warmekaassaus/guitarpedal/(commit log)

2026-10-01 add proven interrupt-based encoder read test
2026-10-01 MVP firmware tested, leds not lit still. potentially hw issue.
    [firmware.ino]
2026-10-05 faster led update and instant feedback from pedal press
2026-10-05 add blue confirmation flash when resetting timer
    [firmware.ino]
2026-10-05 add lock/unlock logic to prevent accidental edits
    [firmware.ino]
2026-10-05 prevent pedal presses while unlocked
    [firmware.ino]
2026-10-05 prevent knob inputs while running or paused - only allow while at base time
    [firmware.ino]
2026-10-05 cleaned up oled viz and blue flashes on all resets, add reset on pedal during overtime
    [firmware.ino]
2026-10-05 pedal hold to reset ms now 1000
    [firmware.ino]
2026-10-06 fix load brightness on startup
    [firmware.ino]
2026-10-06 fix knob click behaviour in brightness adjust screen
    [firmware.ino]
2026-10-07 leds test script
2026-10-07 start led pulses at set brightness for smooth transitions
